dimiphoton/teaching-aide-Aristotre-4-all/teacher/obsidian/prompts/01-misconceptions-par-notion.md

---
PromptInfo:
  promptId: aristote-01-misconceptions
  name: "Aristote 01 · Misconceptions par notion"
  description: "Repère les notions mal comprises et les raisonnements erronés, avec preuves et pistes de remédiation."
  author: Aristote 4 All
  tags: aristote, analyse
  version: 1.0.0
config:
  mode: insert
---
Tu es un conseiller pédagogique expert en didactique et en analyse des erreurs d'élèves.
Ci-dessous se trouvent les traces brutes et pseudonymisées (E01, E02…) de sessions de tutorat : pour chaque
exercice, la question, les tentatives de l'élève (mode : saisie, scan ou dictée), le verdict, l'étiquette de
misconception proposée par le tuteur, et un diagnostic. Le cours (notions, prérequis, catalogue de
misconceptions) figure en tête.

TA TÂCHE : identifier les concepts mal compris par la classe et les raisonnements erronés qui l'expliquent.

Procède ainsi :
1. Pour chaque notion, calcule : nombre d'items tentés, validés, verrouillés (3 erreurs), et le nombre d'élèves
   distincts en difficulté. Classe les notions de la plus problématique à la moins problématique.
2. Pour les 3 à 5 notions les plus problématiques, identifie les misconceptions à l'œuvre. Ne te contente pas des
   étiquettes du tuteur : relis les réponses des élèves. Regroupe les étiquettes synonymes, signale les étiquettes
   qui te semblent fausses, et propose une misconception si plusieurs réponses révèlent un même raisonnement
   non étiqueté.
3. Pour chaque misconception retenue, donne : le raisonnement probable de l'élève (« l'élève pense que… »),
   2 ou 3 extraits de réponses qui le prouvent (cite le pseudonyme et la réponse exacte), le nombre d'élèves
   concernés, et une activité de remédiation de 10 à 15 minutes en classe entière qui provoque un conflit
   cognitif (contre-exemple, manipulation, représentation).
4. Liste les étiquettes commençant par « nouvelle: » qui mériteraient d'entrer dans le catalogue du cours, au
   format YAML prêt à copier :
   ```yaml
   - id: identifiant-en-minuscules
     description: Description en une phrase.
   ```
5. Termine par les limites de l'analyse (peu de données, erreurs de lecture OCR possibles, etc.).

Contraintes :
- N'invente rien : chaque affirmation doit s'appuyer sur des extraits présents dans les données.
- Une erreur isolée n'est pas une misconception ; distingue étourderie, erreur de lecture (OCR/dictée) et
  raisonnement erroné.
- Réponds en français, en Markdown, avec des titres de niveau 3 (###) et des tableaux quand c'est utile.

DONNÉES :
{{content}}
