dimiphoton/teaching-aide-Aristotre-4-all/teacher/obsidian/templates/Rapport-hebdomadaire.md

---
type: rapport
semaine: "{{date:YYYY-[S]ww}}"
---
# Rapport Aristote — semaine {{date:ww}}

> Méthode : 1) `Templater : Preparer-donnees-analyse` (7 jours) ; 2) ouvrir la note de données ;
> 3) lancer les trois prompts Text Generator ; 4) coller les résultats ci-dessous ; 5) relire et décider.
> Les résultats de l'IA sont des **hypothèses** : vérifier les extraits cités avant d'agir.

## 1. Notions et misconceptions de la semaine
<!-- résultat du prompt 01 -->

## 2. Groupes de besoin
<!-- résultat du prompt 02 (remplacer les pseudonymes par les noms ici seulement, dans ce coffre) -->

## 3. Prérequis à reprendre
<!-- résultat du prompt 03 -->

## 4. Mes décisions
- [ ] Activité en classe entière :
- [ ] Groupes de remédiation :
- [ ] Élèves à voir individuellement :
- [ ] Étiquettes 🆕 à ajouter au catalogue du cours :
