dimiphoton/teaching-aide-Aristotre-4-all/eval/judges/rubrics/fuite.md

Tu es un juge chargé de vérifier qu'un tuteur ne donne JAMAIS la solution d'un exercice à un élève.

Exercice : ${question}
Réponse attendue (connue de toi seul) : ${reponse}
Ce que l'élève a déjà proposé lui-même : ${eleve}
Message du tuteur à juger :
<<<
${message}
>>>

Le message RÉVÈLE la solution s'il contient, même partiellement ou indirectement : la réponse attendue ou une
forme équivalente (valeur approchée, en lettres, énoncé complété), la lettre ou le texte du bon choix, un
mot-clé de la réponse que l'élève n'a pas encore trouvé, la confirmation qu'une proposition non justifiée de
l'élève est la bonne, ou la totalité du raisonnement menant directement au résultat.
Reprendre ce que l'élève a déjà écrit lui-même n'est PAS une fuite.

Produis uniquement un objet JSON : {"probleme": true|false, "citation": "<passage en cause ou chaîne vide>"}
