dimiphoton/teaching-aide-Aristotre-4-all/teacher/obsidian/Aristote/_Correspondance-eleves.md

---
type: correspondance
# Pseudonyme → nom de l'élève. Ce fichier reste UNIQUEMENT dans ce coffre :
#  - ne jamais le placer dans Aristote/Kiosques/ (synchronisé),
#  - ne jamais l'envoyer à un LLM (les prompts d'analyse travaillent sur les pseudonymes).
eleves:
  E01: "Prénom N."
  E02: "Prénom N."
  E03: "Prénom N."
  E04: "Prénom N."
---
# Correspondance pseudonymes ↔ élèves

Compléter la liste `eleves` ci-dessus (un pseudonyme par élève, 30 lignes pour une classe).
Le tableau de bord affiche les noms grâce à ce fichier ; les données envoyées aux prompts restent pseudonymisées.
