dimiphoton/teaching-aide-Aristotre-4-all/hardware/enclosure/stl/coque_gauche.stl

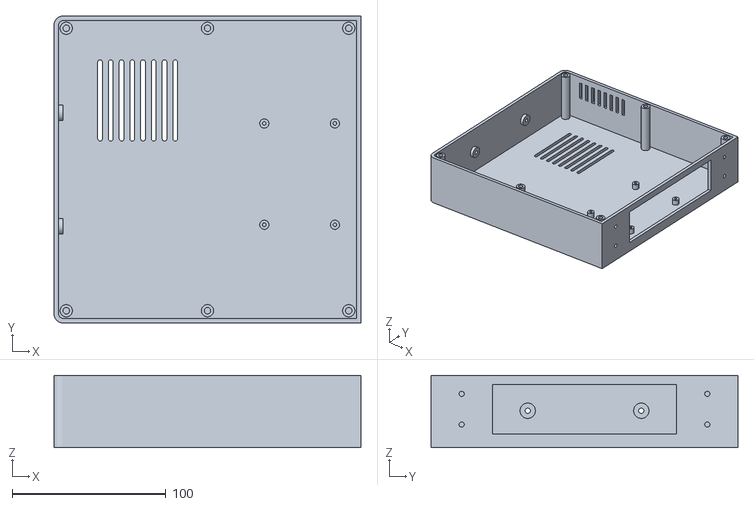
[picture p5: CAD file, 2026-10-23]
hardware/enclosure/stl/coque_gauche.stl
200.0 x 200.0 x 47.0
