dimiphoton/teaching-aide-Aristotre-4-all/hardware/enclosure/stl/support_ecran_droit.stl

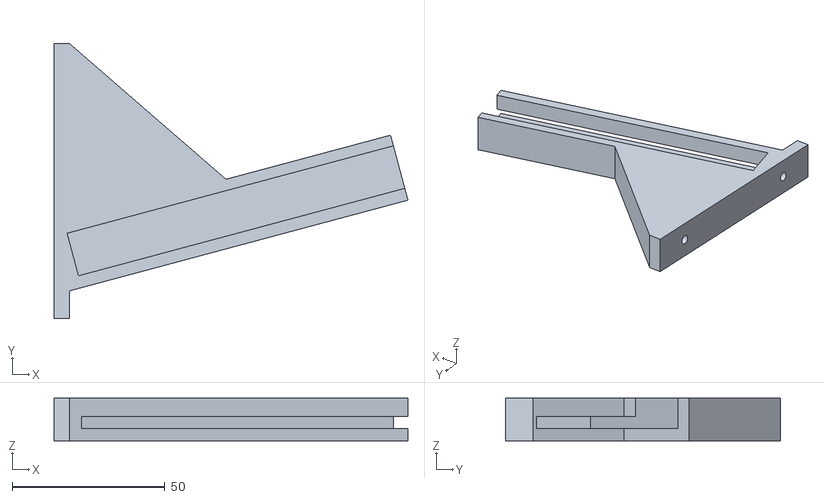
[picture p6: CAD file, 2026-10-23]
hardware/enclosure/stl/support_ecran_droit.stl
115.8 x 90.0 x 14.0
