dimiphoton/teaching-aide-Aristotre-4-all/hardware/enclosure/stl/bras_camera.stl

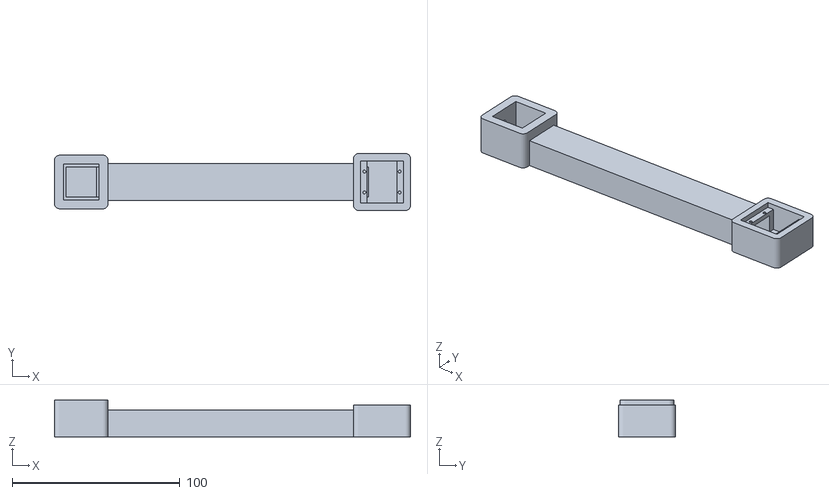
[picture p7: CAD file, 2026-10-23]
hardware/enclosure/stl/bras_camera.stl
212.5 x 34.0 x 22.0
