dimiphoton/teaching-aide-Aristotre-4-all/hardware/enclosure/stl/dessus_gauche.stl

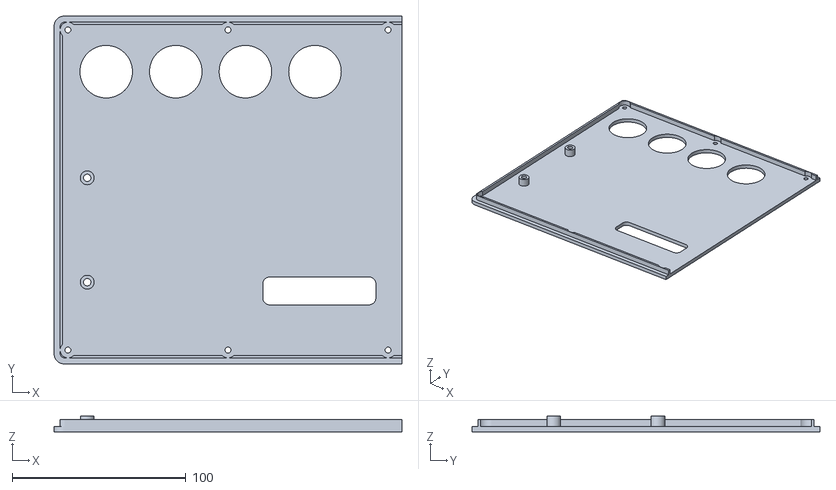
[picture p8: CAD file, 2026-10-23]
hardware/enclosure/stl/dessus_gauche.stl
200.0 x 200.0 x 9.00
