dimiphoton/teaching-aide-Aristotre-4-all/hardware/enclosure/stl/mat_embase.stl

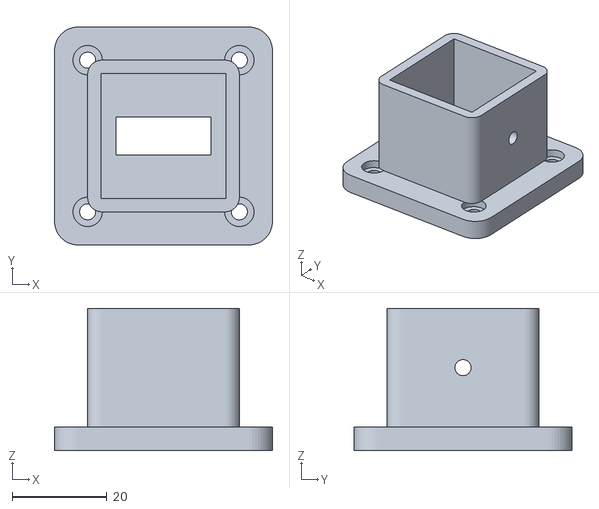
[picture p9: CAD file, 2026-10-23]
hardware/enclosure/stl/mat_embase.stl
46.0 x 46.0 x 30.0
