dimiphoton/teaching-aide-Aristotre-4-all/hardware/enclosure/stl/nacelle_imprimante.stl

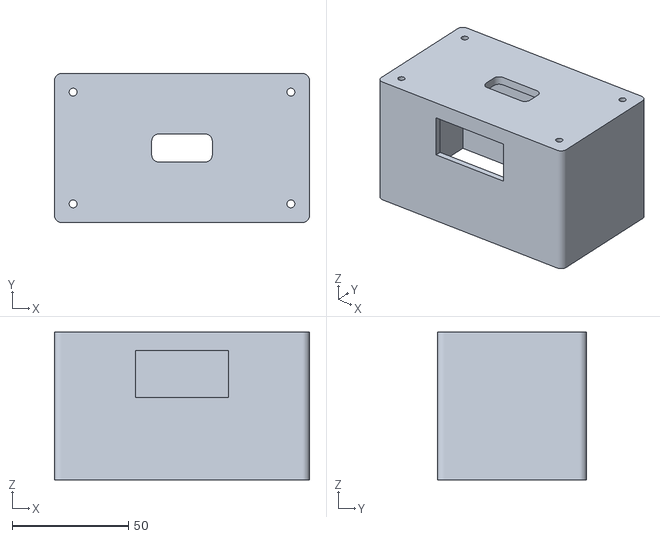
[picture p10: CAD file, 2026-10-23]
hardware/enclosure/stl/nacelle_imprimante.stl
109.5 x 64.0 x 63.5
