dimiphoton/teaching-aide-Aristotre-4-all/hardware/enclosure/stl/coin_scan.stl

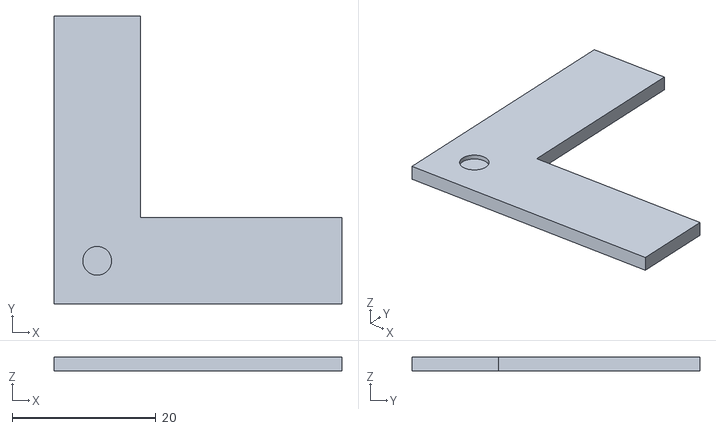
[picture p11: CAD file, 2026-10-23]
hardware/enclosure/stl/coin_scan.stl
40.0 x 40.0 x 2.00
