dimiphoton/teaching-aide-Aristotre-4-all/hardware/enclosure/stl/dessus_droit.stl

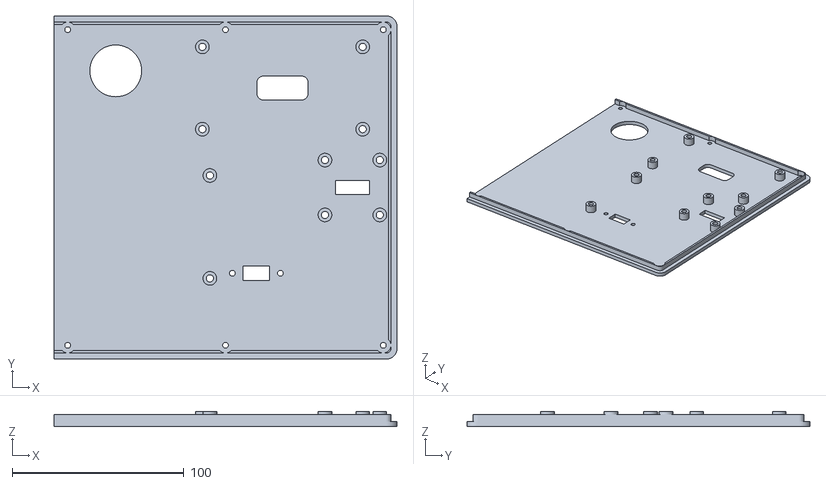
[picture p12: CAD file, 2026-10-23]
hardware/enclosure/stl/dessus_droit.stl
200.0 x 200.0 x 9.00
