dimiphoton/teaching-aide-Aristotre-4-all/hardware/enclosure/stl/mat_segment.stl

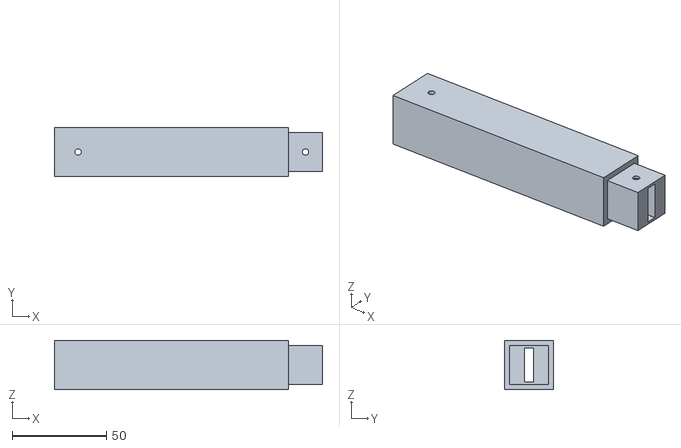
[picture p13: CAD file, 2026-10-23]
hardware/enclosure/stl/mat_segment.stl
142.0 x 26.0 x 26.0
