dimiphoton/teaching-aide-Aristotre-4-all/hardware/enclosure/stl/station_accessoires.stl

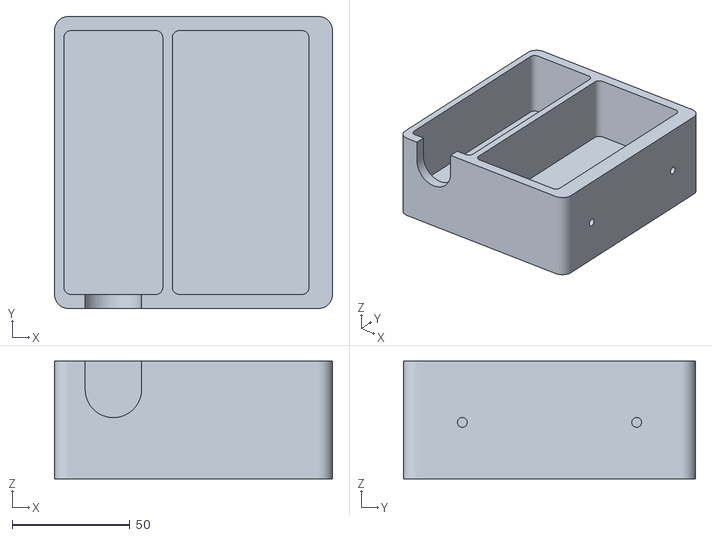
[picture p14: CAD file, 2026-10-23]
hardware/enclosure/stl/station_accessoires.stl
118.0 x 124.0 x 50.0
