dimiphoton/teaching-aide-Aristotre-4-all/(list of files, cad)

Other CAD files:
hardware/enclosure/stl/coque_droite.stl
hardware/enclosure/stl/support_ecran_gauche.stl
