dimiphoton/teaching-aide-Aristotre-4-all/backend/aristote/tutor/prompts/turn_instructions.md

## Situation
- Notion : ${notion}
- Question posée : ${question}
- Dernière réponse de l'élève : « ${reponse_eleve} »
- Ce qui est juste dans sa démarche : ${elements_justes}
- Erreur de raisonnement probable : ${misconception}
- Indices du professeur (à reformuler, jamais à recopier s'ils contiennent la solution) : ${indices}

## Ce que tu dois faire maintenant
${consigne_action}

Réponds directement à l'élève, en texte simple (pas de Markdown, pas de LaTeX), 3 phrases maximum.
