dimiphoton/teaching-aide-Aristotre-4-all/teacher/obsidian/prompts/03-verification-prerequis.md

---
PromptInfo:
  promptId: aristote-03-prerequis
  name: "Aristote 03 · Vérification des prérequis"
  description: "Relie les échecs aux prérequis non maîtrisés et vérifie la cohérence du graphe de prérequis du cours."
  author: Aristote 4 All
  tags: aristote, analyse
  version: 1.0.0
config:
  mode: insert
---
Tu es un conseiller pédagogique spécialiste de la progression des apprentissages. Ci-dessous se trouvent la
structure du cours (chaque notion avec ses prérequis) et les traces pseudonymisées (E01, E02…) des sessions.
Quand un élève échoue 3 fois, le tuteur verrouille l'exercice et lui propose un prérequis (ligne « Prérequis
proposé »).

TA TÂCHE : vérifier les prérequis, élève par élève et pour le cours lui-même.

Procède ainsi :
1. **Élèves.** Pour chaque élève ayant au moins un exercice verrouillé, indique dans un tableau :
   notion échouée → prérequis concernés → état observé de chaque prérequis (validé / échoué / jamais travaillé)
   → diagnostic : « lacune de prérequis » (le prérequis n'est pas maîtrisé), « difficulté propre à la notion »
   (prérequis maîtrisés) ou « indéterminé » (prérequis jamais travaillés).
2. **Remédiation.** Pour les élèves en « lacune de prérequis », propose l'ordre de travail recommandé (du prérequis
   le plus fondamental vers la notion visée) et ce qu'il faut vérifier en classe avant de reprendre la notion.
3. **Remédiation du tuteur.** Après un verrou, l'élève a-t-il ensuite réussi le prérequis proposé, puis la notion ?
   Évalue si la stratégie automatique semble efficace, avec les cas observés.
4. **Cohérence du cours.** Repère les incohérences du graphe de prérequis :
   - élèves qui réussissent une notion tout en échouant son prérequis (prérequis peut-être inutile ou mal défini) ;
   - notions souvent échouées alors que leurs prérequis sont validés (prérequis manquant probable : lequel ?).
   Propose les modifications au format YAML du cours (champ `prerequis`).
5. Termine par les élèves pour lesquels les données ne permettent pas de conclure.

Contraintes :
- Appuie chaque conclusion sur des sessions identifiées (pseudonyme + date).
- N'invente aucune notion qui n'existe pas dans la structure du cours, sauf dans la partie 4 où tu peux suggérer
  d'en créer une en le signalant clairement.
- Réponds en français, en Markdown, avec des titres de niveau 3 (###).

DONNÉES :
{{content}}
