dimiphoton/teaching-aide-Aristotre-4-all/(commit log)

2026-10-14 Ajoute l'architecture, la BOM et la licence PolyForm Noncommercial 1.0.0
    Claude-Session: https://claude.ai/code/session_01RePvVU7x8ijtqRdwbAbi3H
2026-10-14 Ajoute les critères et le protocole d'évaluation des versions
    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
2026-10-14 Backend : pilotes matériels, stockage Markdown et gestion des sessions
    - Pilote CSN-A2 (CP437, mise en forme, images, capteur papier, temporisation)
    - Caméra (picamera2, OpenCV, simulation) avec détection et redressement de page
    - Boutons GPIO / clavier HID, LED via ULN2803A, micro WAV 16 kHz
    - Stockage Markdown atomique, en-têtes Dataview, neutralisation du texte élève
    - Profils pseudonymisés, gestion des sessions (bascule, appui long, inactivité)
    - Outil de diagnostic « aristote diag » et 35 tests
    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
2026-10-14 Backend IA : tuteur socratique, garde anti-fuite, OCR, dictée et API
    - Format de cours générique (5 types de réponse) et cours de démonstration multi-matières
    - Vérification déterministe des réponses et détecteur de fuite (critère G1)
    - Machine à états : relance, indice, verrou à la 3e erreur (critère G2)
    - Agent : choix des items par prérequis, ticket de remédiation, messages de repli hors ligne
    - Moteurs OCR (Tesseract, VLM compatible OpenAI, Mistral OCR) et dictée faster-whisper
    - Corpus d'évaluation local (option eval_capture), API REST + WebSocket
    Claude-Session: https://claude.ai/code/session_01RePvVU7x8ijtqRdw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
2026-10-14 Interface du kiosque (Vue 3) : accueil, tuteur, scan, dictée, diagnostic
    Clavier à l'écran AZERTY avec symboles mathématiques, relais des boutons clavier HID (F13-F17),
    WebSocket avec reconnexion, écran d'administration protégé par code PIN.
    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
2026-10-14 Déploiement (Pi OS, systemd, Syncthing, hub Ollama) et coffre Obsidian du professeur
    - install.sh idempotent, provisionnement d'un kiosque, règle udev de l'imprimante
    - Services backend (durci) et interface plein écran cage + Chromium ; alternative rsync
    - Syncthing envoi seul / réception seule, mode réseau local uniquement
    - Tableau de bord Dataview, préparation des données (Templater) et 3 prompts Text Generator
    - Le kiosque publie la structure du cours (sans les réponses) dans cours.md
    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
2026-10-14 Harnais d'évaluation : scénarios générés, élève simulé, jury, rapport comparatif
    - Scénarios par item (5 profils) et 8 attaques génériques, indépendants de la matière
    - Critères éliminatoires G1-G5, critères notés, score pondéré, rapport A vs B
    - Jury multi-modèles avec kappa pondéré, classe synthétique pour les prompts du professeur
    - OCR/dictée sur corpus réel, délais et endurance sur kiosque
    - Corrige deux fuites trouvées par le harnais dans le ticket de remédiation de repli
    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
2026-10-14 Plateau modulaire imprimable en 3D (OpenSCAD) : pièces, STL, câblage
    - Plateau 400 × 200 × 50 en 2 coques + 2 dessus, modules enfichables sur inserts :
    supports d'écran, nacelle CSN-A2, mât de caméra creux + bras, prise USB du micro,
    station agrafeuse/dévidoir, coins de zone de scan
    - build.sh génère les 12 STL et vérifie qu'ils tiennent sur un plateau 220 × 220
    - Câblage détaillé (GPIO, ULN2803A, imprimante, nappe caméra 1 m) et BOM mise à jour
    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
    [assembly.scad, base.scad, bras_camera.stl, coin_scan.stl, coque_droite.stl, coque_gauche.stl, dessus_droit.stl, dessus_gauche.stl]
2026-10-14 Documentation complète et intégration continue
    - README : fonctionnement, matériel, montage, installation, Obsidian, évaluation, avertissement de licence
    - Guides : montage, installation, professeur, RGPD, formats de données ; arborescence à jour
    - CI GitHub Actions : tests backend et harnais, évaluation hors ligne, build de l'interface, STL
    - L'imprimante simulée journalise ses tickets
    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
